jostroeb/optomechatronic_installation/images/bottom.png

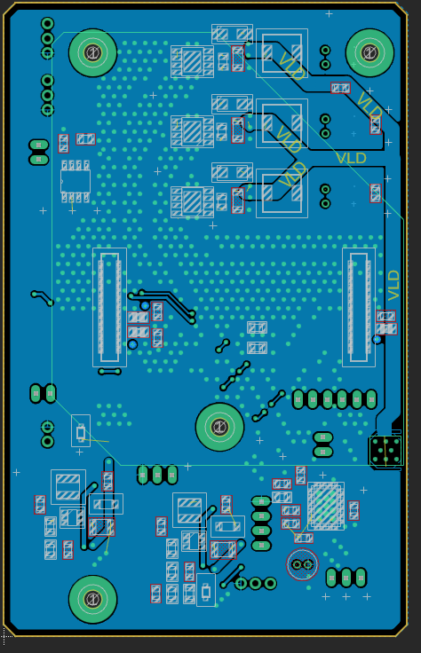
images/bottom.png
