jostroeb/optomechatronic_installation/images/platine_top.png

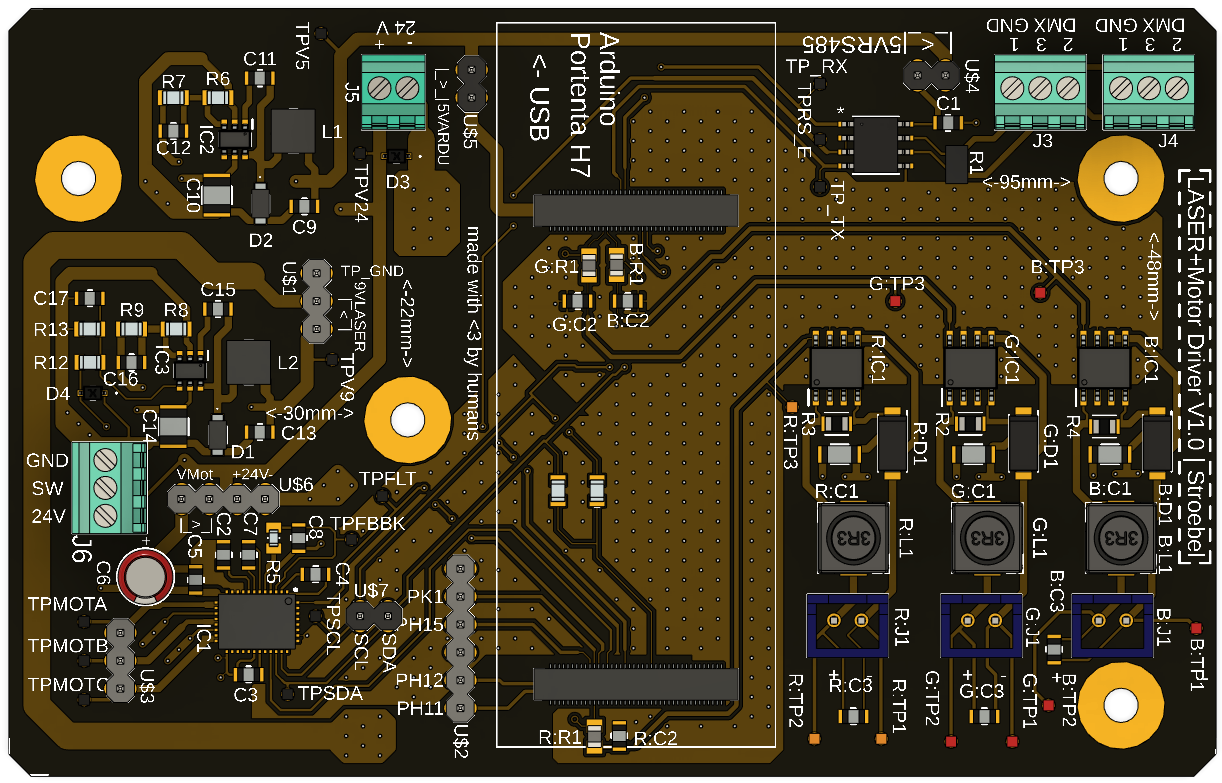
images/platine_top.png
