jostroeb/optomechatronic_installation/images/top.png

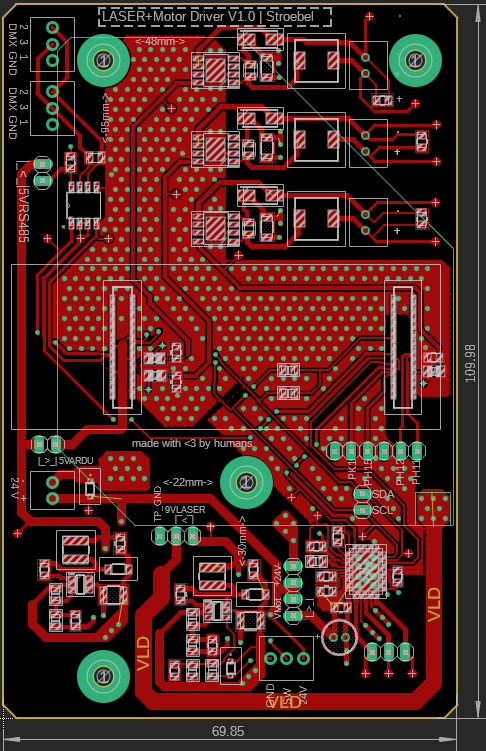
images/top.png
