jostroeb/optomechatronic_installation/(commit log)

2025-04-09 Added pcb images
2025-05-16 Add motor controller programming
